Agilack/cowmotics-aquarea/hardware/preview-3d.png

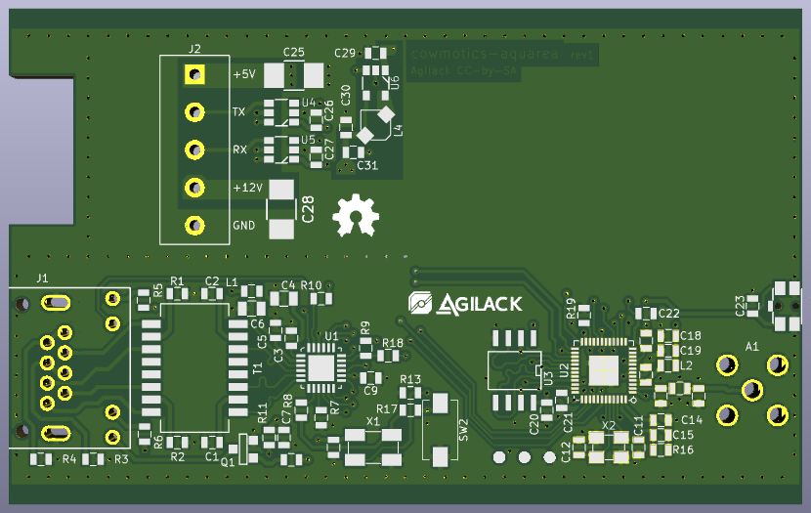
hardware/preview-3d.png
