Agilack/cowmotics-aquarea/hardware/preview.png

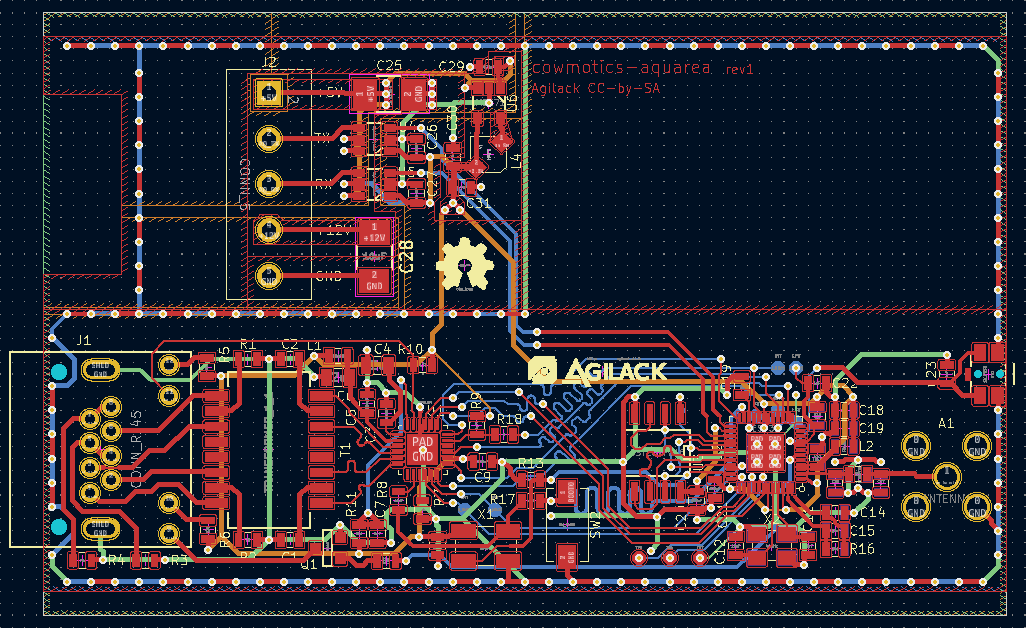
hardware/preview.png
