Agilack/cowmotics-aquarea/hardware/prj-kicad/cowmotics-aquarea.kicad_pcb

## KiCad design hardware/prj-kicad/cowmotics-aquarea.kicad_pcb (2022-01-14)

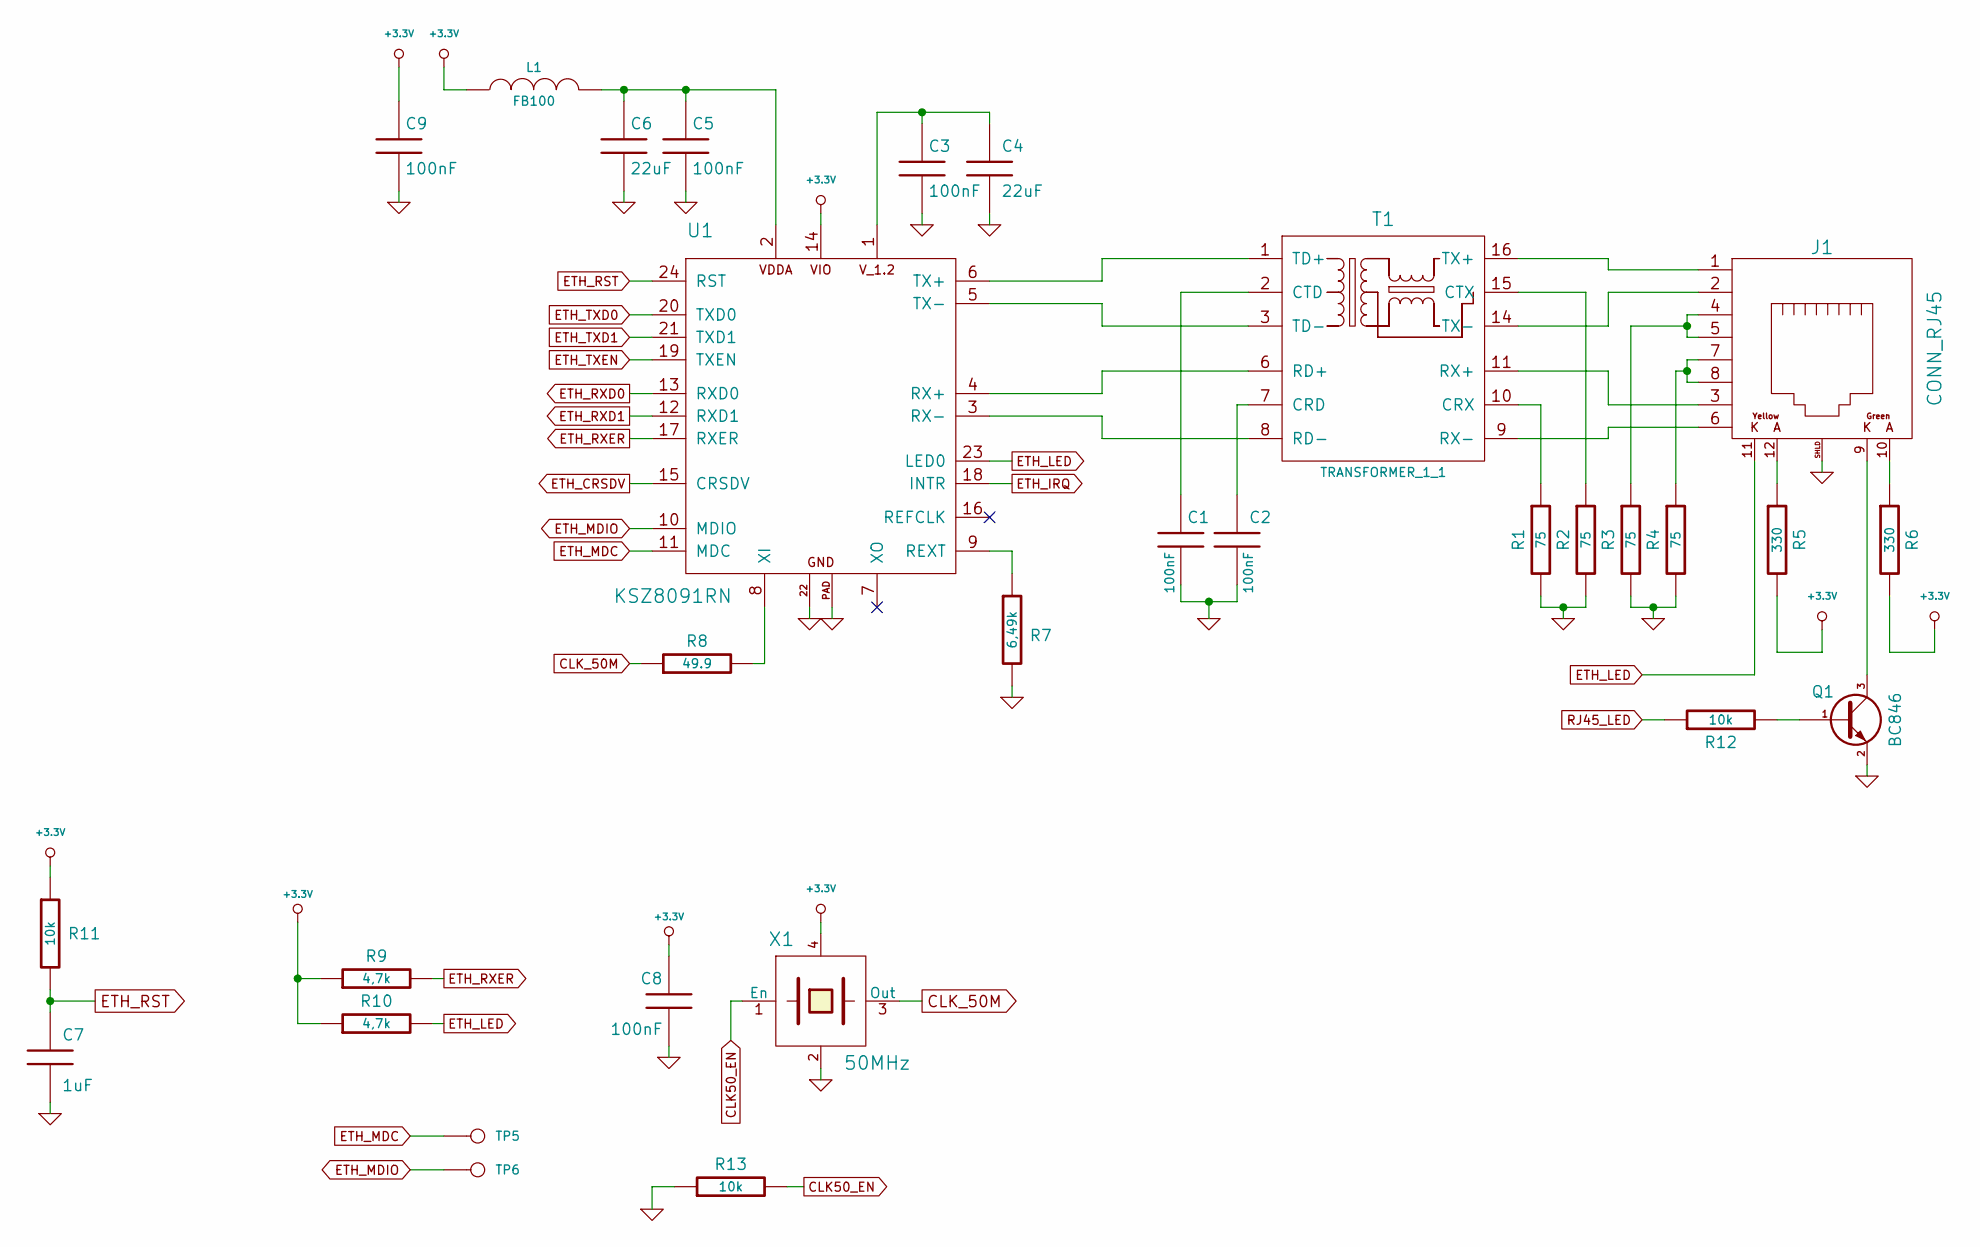
[picture p3: schematic ethernet.kicad_sch, Cowmotics Panadonic Aquarea gateway]

Parts:
C1, C2, C3, C5, C8, C9: 100nF; SMD0603
C4, C6: 22uF; SMD0805
C7: 1uF; SMD0603
J1: CONN_RJ45; CONN_615008185121
L1: FB100; SMD0603
Q1: BC846; SOT23-3
R1, R2, R3, R4: 75; SMD0603
R5, R6: 330; SMD0603
R7: 6,49k; SMD0603
R8: 49.9; SMD0603
R9, R10: 4,7k; SMD0603
R11, R12, R13: 10k; SMD0603
T1: TRANSFORMER_1_1; TR_W749013011
TP5, TP6: CONN_1; TP_SMD
U1: KSZ8091RN; QFN24
X1: 50MHz; Q_SMD5x3

Connections:
+3.3V: C8.1, C9.1, L1.1, R5.2, R6.2, R9.1, R10.1, R11.1, U1.14, X1.4; also elsewhere on the board
CLK50_EN: R13.2, X1.1 (En); also elsewhere on the board
CLK_50M: R8.1, X1.3 (Out); also elsewhere on the board
ETH_CRSDV: U1.15 (CRSDV); also elsewhere on the board
ETH_IRQ: U1.18 (INTR); also elsewhere on the board
ETH_LED: J1.11, R10.2, U1.23 (LED0)
ETH_MDC: TP5.1, U1.11 (MDC); also elsewhere on the board
ETH_MDIO: TP6.1, U1.10 (MDIO); also elsewhere on the board
ETH_RST: C7.1, R11.2, U1.24 (RST)
ETH_RXD0: U1.13 (RXD0); also elsewhere on the board
ETH_RXD1: U1.12 (RXD1); also elsewhere on the board
ETH_RXER: R9.2, U1.17 (RXER); also elsewhere on the board
ETH_TXD0: U1.20 (TXD0); also elsewhere on the board
ETH_TXD1: U1.21 (TXD1); also elsewhere on the board
ETH_TXEN: U1.19 (TXEN); also elsewhere on the board
GND: C1.2, C2.2, C3.2, C4.2, C5.2, C6.2, C7.2, C8.2, C9.2, J1.SHLD, Q1.2 (E), R1.2, R2.2, R3.2, R4.2, R7.2, R13.1, U1.22, U1.PAD, X1.2; also elsewhere on the board
unnamed: C1.1, T1.2 (CTD)
unnamed: C2.1, T1.7 (CRD)
unnamed: C3.1, C4.1, U1.1
unnamed: C5.1, C6.1, L1.2, U1.2
unnamed: J1.1, T1.16 (TX+)
unnamed: J1.2, T1.14 (TX-)
unnamed: J1.3, T1.11 (RX+)
unnamed: J1.4, J1.5, R3.1
unnamed: J1.6, T1.9 (RX-)
unnamed: J1.7, J1.8, R4.1
unnamed: J1.9, Q1.3 (C)
unnamed: J1.10, R6.1
unnamed: J1.12, R5.1
unnamed: Q1.1 (B), R12.2
unnamed: R1.1, T1.10 (CRX)
unnamed: R2.1, T1.15 (CTX)
unnamed: R7.1, U1.9 (REXT)
unnamed: R8.2, U1.8 (XI)
unnamed: T1.1 (TD+), U1.6 (TX+)
unnamed: T1.3 (TD-), U1.5 (TX-)
unnamed: T1.6 (RD+), U1.4 (RX+)
unnamed: T1.8 (RD-), U1.3 (RX-)
RJ45_LED: R12.1; also elsewhere on the board

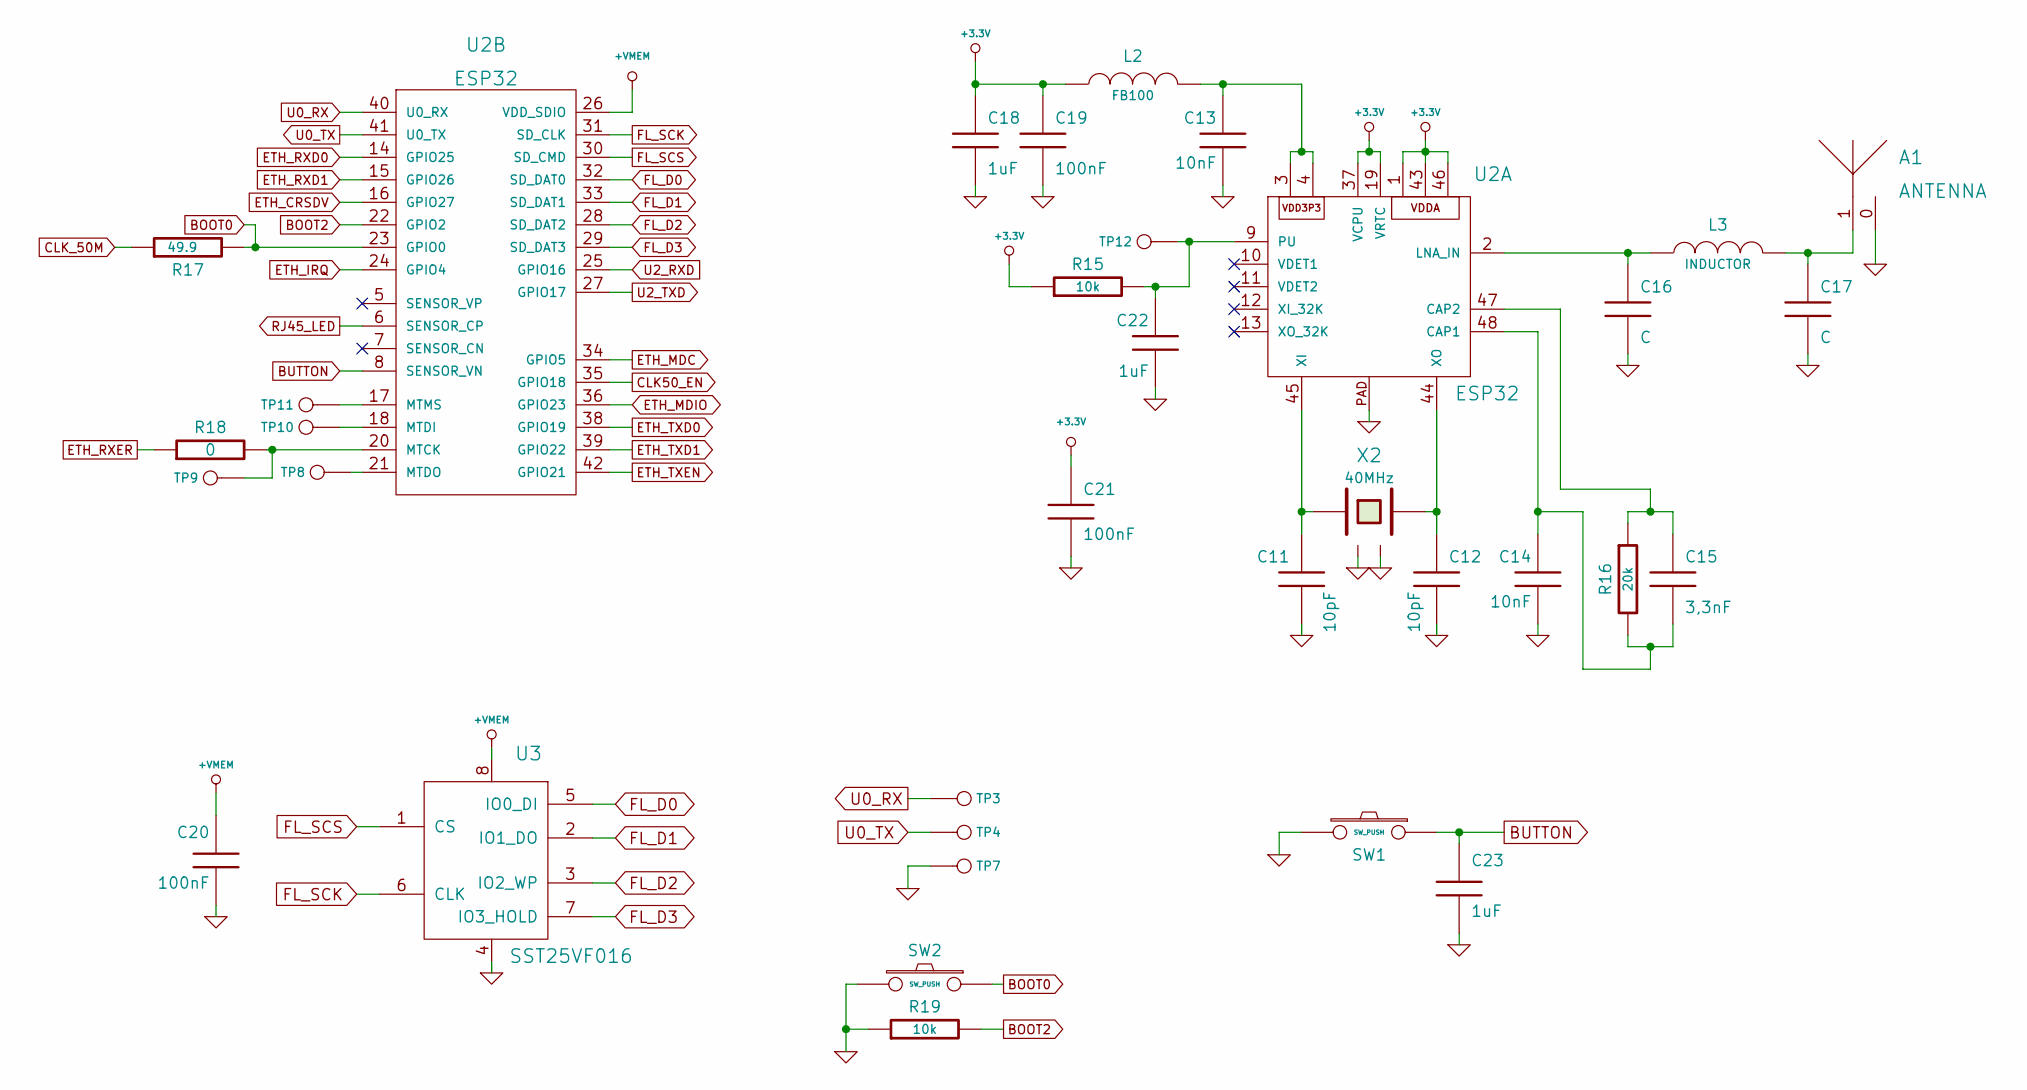
[picture p4: schematic mcu.kicad_sch, Cowmotics Aquarea : Processor (and wifi)]

Parts:
A1: ANTENNA; CONN_SMA_RA
C11, C12: 10pF; SMD0603
C13, C14: 10nF; SMD0603
C15: 3,3nF; SMD0603
C16, C17: C; SMD0603
C18, C22, C23: 1uF; SMD0603
C19, C20, C21: 100nF; SMD0603
L2: FB100; SMD0603
L3: INDUCTOR; SMD0603
R15, R19: 10k; SMD0603
R16: 20k; SMD0603
R17: 49.9; SMD0603
R18: 0; SMD0603
SW1: SW_PUSH; SW_PTS840
SW2: SW_PUSH; SW_434123043816
TP3, TP4, TP7, TP8, TP9, TP10, TP11, TP12: CONN_1; TP_SMD
U2: ESP32; QFN48-04
U3: SST25VF016; SOIC-8
X2: 40MHz; Q_3.2x2.5

Connections:
+3.3V: C18.1, C19.1, C21.1, L2.1, R15.1, U2.1, U2.19 (VRTC), U2.37 (VCPU), U2.43, U2.46; also elsewhere on the board
+VMEM: C20.1, U2.26 (VDD_SDIO), U3.8
BOOT0: R17.2, SW2.1, U2.23 (GPIO0)
BOOT2: R19.2, U2.22 (GPIO2)
BUTTON: C23.1, SW1.1, U2.8 (SENSOR_VN)
CLK50_EN: U2.35 (GPIO18); also elsewhere on the board
CLK_50M: R17.1; also elsewhere on the board
ETH_CRSDV: U2.16 (GPIO27); also elsewhere on the board
ETH_IRQ: U2.24 (GPIO4); also elsewhere on the board
ETH_MDC: U2.34 (GPIO5); also elsewhere on the board
ETH_MDIO: U2.36 (GPIO23); also elsewhere on the board
ETH_RXD0: U2.14 (GPIO25); also elsewhere on the board
ETH_RXD1: U2.15 (GPIO26); also elsewhere on the board
ETH_RXER: R18.1; also elsewhere on the board
ETH_TXD0: U2.38 (GPIO19); also elsewhere on the board
ETH_TXD1: U2.39 (GPIO22); also elsewhere on the board
ETH_TXEN: U2.42 (GPIO21); also elsewhere on the board
FL_D0: U2.32 (SD_DAT0), U3.5 (IO0_DI)
FL_D1: U2.33 (SD_DAT1), U3.2 (IO1_DO)
FL_D2: U2.28 (SD_DAT2), U3.3 (IO2_WP)
FL_D3: U2.29 (SD_DAT3), U3.7 (IO3_HOLD)
FL_SCK: U2.31 (SD_CLK), U3.6 (CLK)
FL_SCS: U2.30 (SD_CMD), U3.1 (CS)
GND: A1.0, C11.2, C12.2, C13.2, C14.2, C16.2, C17.2, C18.2, C19.2, C20.2, C21.2, C22.2, C23.2, R19.1, SW1.2, SW2.2, TP7.1, U2.PAD, U3.4, X2.2, X2.4; also elsewhere on the board
unnamed: A1.1, C17.1, L3.2
unnamed: C11.1, U2.45 (XI), X2.3
unnamed: C12.1, U2.44 (XO), X2.1
unnamed: C13.1, L2.2, U2.3, U2.4
unnamed: C14.1, C15.2, R16.2, U2.48 (CAP1)
unnamed: C15.1, R16.1, U2.47 (CAP2)
unnamed: C16.1, L3.1, U2.2 (LNA_IN)
unnamed: C22.1, R15.2, TP12.1, U2.9 (PU)
unnamed: R18.2, TP9.1, U2.20 (MTCK)
unnamed: TP8.1, U2.21 (MTDO)
unnamed: TP10.1, U2.18 (MTDI)
unnamed: TP11.1, U2.17 (MTMS)
RJ45_LED: U2.6 (SENSOR_CP); also elsewhere on the board
U0_RX: TP3.1, U2.40 (U0_RX)
U0_TX: TP4.1, U2.41 (U0_TX)
U2_RXD: U2.25 (GPIO16); also elsewhere on the board
U2_TXD: U2.27 (GPIO17); also elsewhere on the board

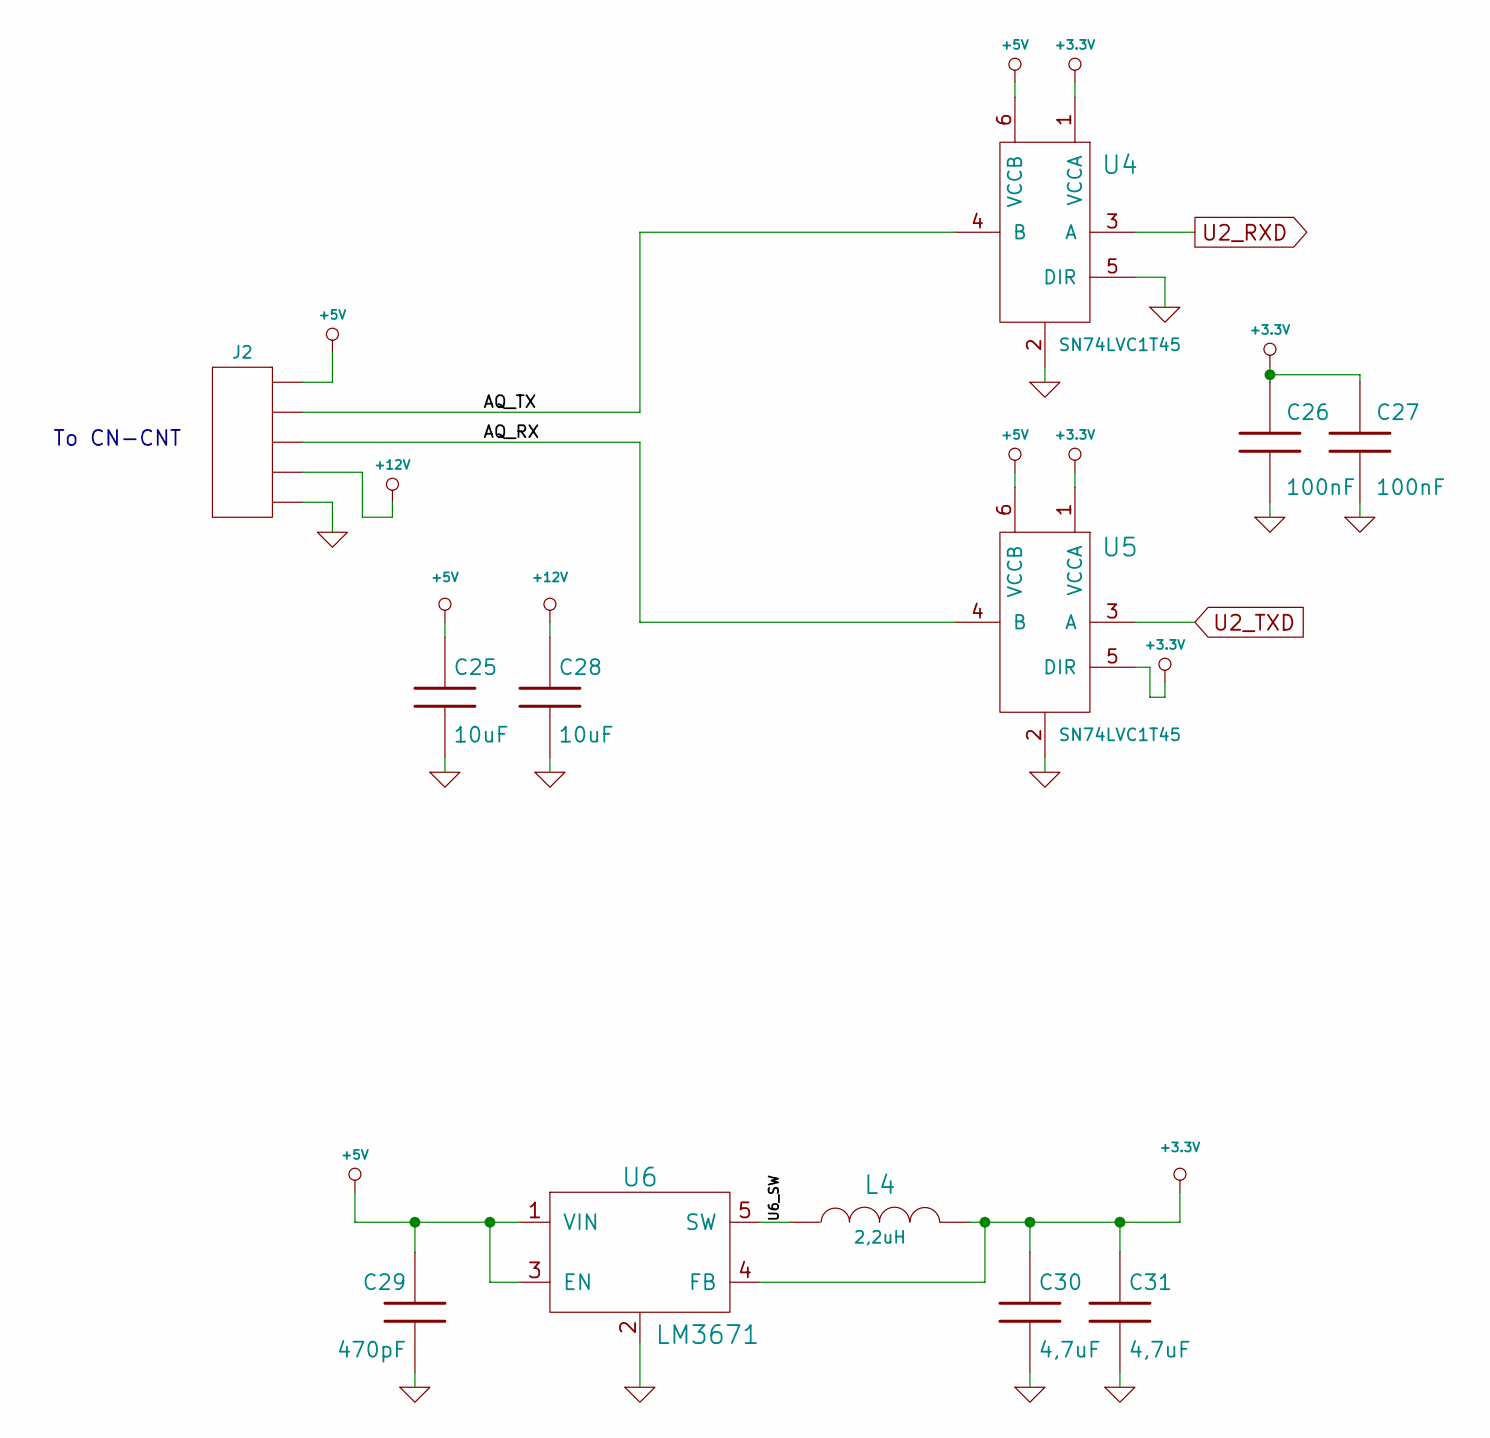
[picture p5: schematic aquarea.kicad_sch, Cowmotics Panadonic Aquarea gateway]

Parts:
C25, C28: 10uF; SMD1210
C26, C27: 100nF; SMD0603
C29: 470pF; SMD0603
C30, C31: 4,7uF; SMD0603
J2: CONN_5; CONN_691243310005
L4: 2,2uH; I_CDRH2D14
U4, U5: SN74LVC1T45; SOT23-6
U6: LM3671; SOT23-5

Connections:
+3.3V: C26.1, C27.1, C30.1, C31.1, L4.2, U4.1 (VCCA), U5.1 (VCCA), U5.5 (DIR), U6.4 (FB); also elsewhere on the board
+5V: C25.1, C29.1, J2.1, U4.6 (VCCB), U5.6 (VCCB), U6.1 (VIN), U6.3 (EN)
+12V: C28.1, J2.4
/Aquarea Interface/AQ_RX: J2.3, U5.4 (B)
/Aquarea Interface/AQ_TX: J2.2, U4.4 (B)
/Aquarea Interface/U6_SW: L4.1, U6.5 (SW)
GND: C25.2, C26.2, C27.2, C28.2, C29.2, C30.2, C31.2, J2.5, U4.2, U4.5 (DIR), U5.2, U6.2; also elsewhere on the board
U2_RXD: U4.3 (A); also elsewhere on the board
U2_TXD: U5.3 (A); also elsewhere on the board

Notes on the sheet:
To CN-CNT

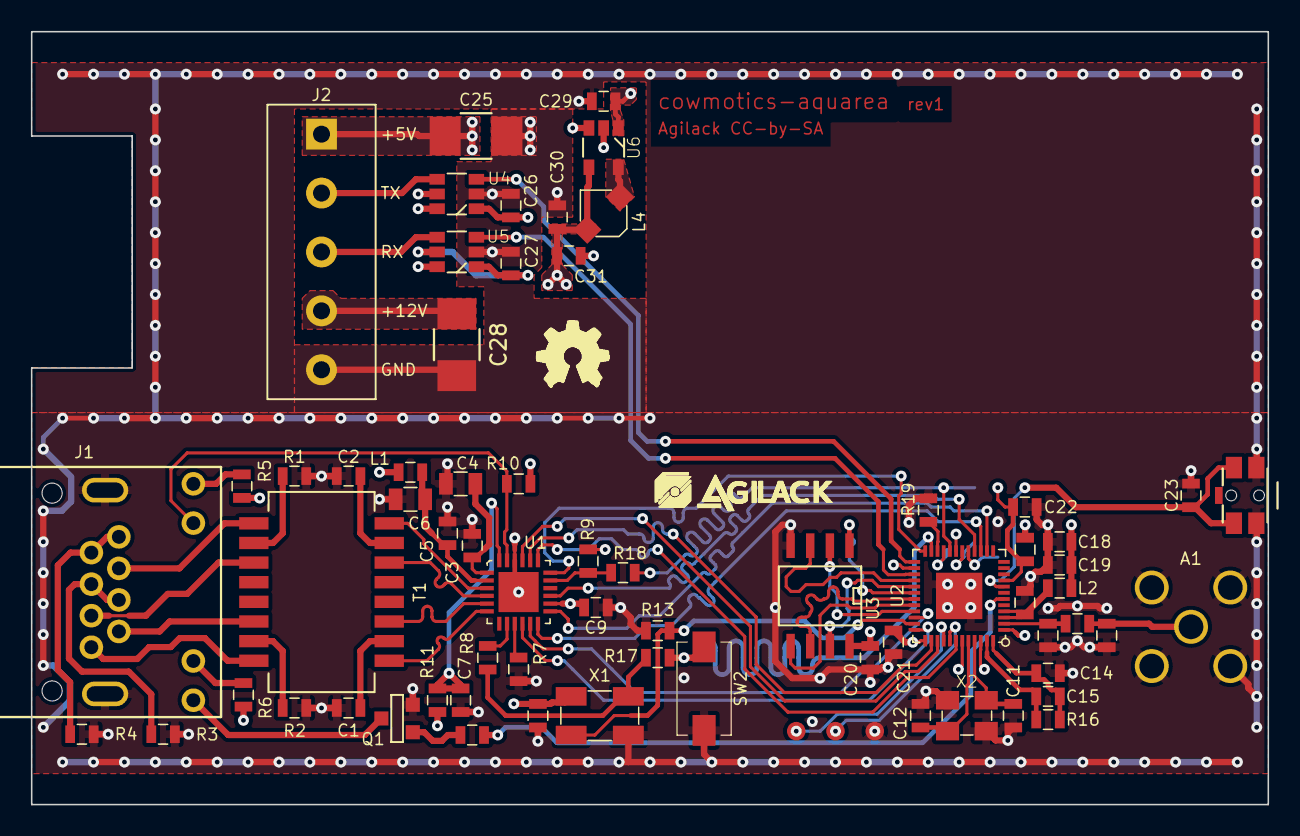
[picture p6: board cowmotics-aquarea.kicad_pcb from above]

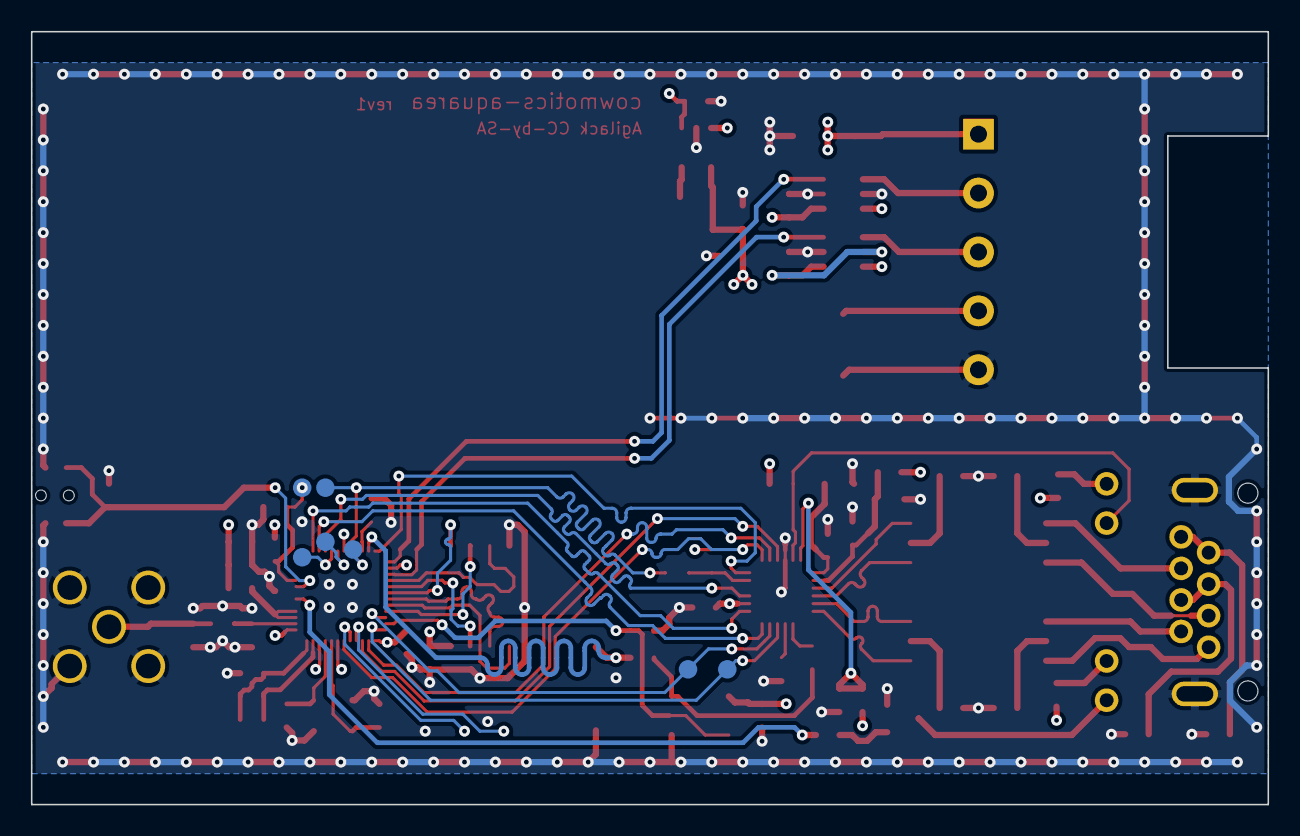
[picture p7: board cowmotics-aquarea.kicad_pcb from below]

Board: 4 copper layers, 80.0 x 50.0 mm, 78 parts (7 on the bottom side), 70 nets.

Other parts of the board:
agilack-11.5: 450px; logo-agilack-11.5
ohw_logo: VAL**; logo-ohw
