Agilack/cowmotics-aquarea/(commit log)

2022-01-10 = Create project, add board skeleton, insert ethernet (sch+routing)
    [cowmotics-aquarea.kicad_pcb, cowmotics-aquarea.kicad_sch, ethernet.kicad_sch]
2022-01-11 = ADD: Insert ESP32 processor and his main components
    [cowmotics-aquarea.kicad_pcb, cowmotics-aquarea.kicad_sch, mcu.kicad_sch]
2022-01-12 = UPD: Finish ESP32 routing (eth, boot, console, ...)
    [cowmotics-aquarea.kicad_pcb, cowmotics-aquarea.kicad_sch, ethernet.kicad_sch, mcu.kicad_sch]
2022-01-13 = ADD: Insert Aquarea serial interface and power supply
    [aquarea.kicad_sch, cowmotics-aquarea.kicad_pcb, cowmotics-aquarea.kicad_sch]
2022-01-14 = ADD: Create production files for rev1
    [cowmotics-aquarea-B_Cu.gbr, cowmotics-aquarea-B_Mask.gbr, cowmotics-aquarea-B_Paste.gbr, cowmotics-aquarea-B_Silkscreen.gbr, cowmotics-aquarea-Edge_Cuts.gbr, cowmotics-aquarea-F_Cu.gbr, cowmotics-aquarea-F_Mask.gbr, cowmotics-aquarea-F_Paste.gbr]
2022-01-22 Firmware: Insert a module for low-level aquarea communiation (uart reception)
2022-01-23 Firmware: Improve low-level uart and create a functional module for Aquarea
