Agilack/cowmotics-aquarea/(notices)

Notices in the files:
hardware/prj-kicad/ethernet.kicad_sch:
Licence: CC-by-SA
hardware/prj-kicad/cowmotics-aquarea.kicad_pcb:
Agilack CC-by-SA
